floresacton/kicad-lib/3dmodels/XT30PW-M.STEP

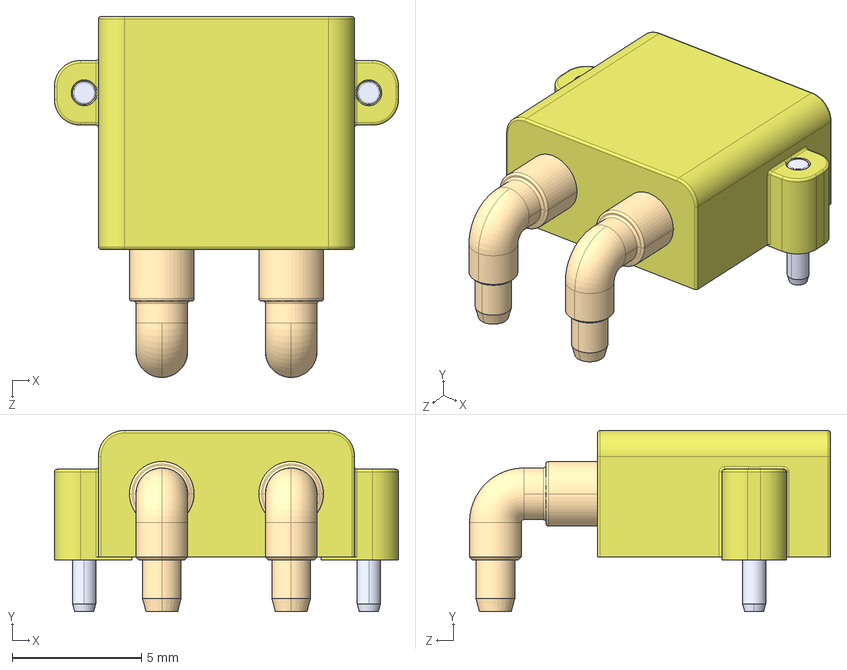
[picture p1: CAD file, 2024-11-22]
3dmodels/XT30PW-M.STEP
13.3 x 7.00 x 14.0 mm
