floresacton/kicad-lib/3dmodels/SM04B-SRSS-TB.STEP

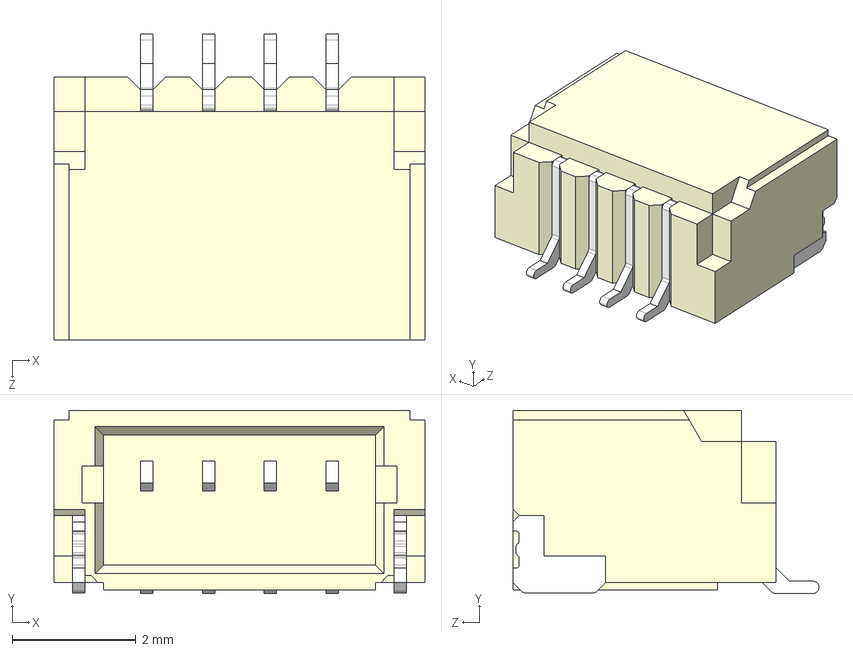
[picture p2: CAD file, 2024-10-28]
3dmodels/SM04B-SRSS-TB.STEP
6.00 x 2.96 x 4.95 mm
