floresacton/kicad-lib/3dmodels/BM04B-SRSS-TB.STEP

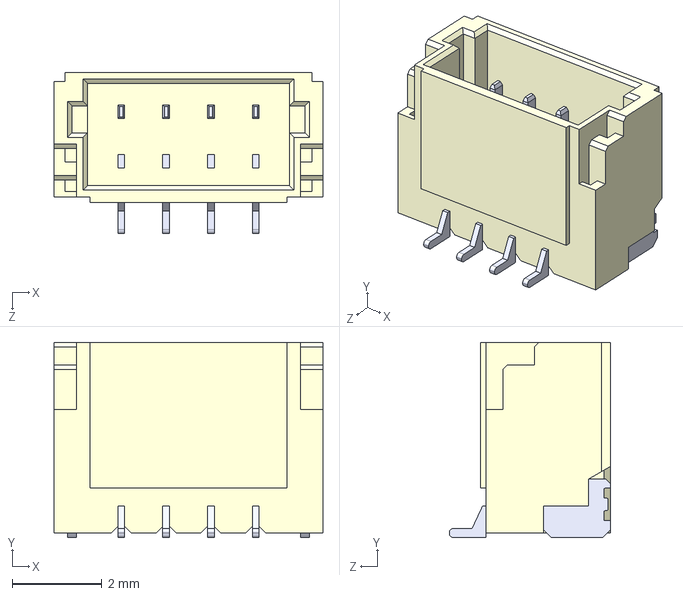
[picture p3: CAD file, 2024-08-16]
3dmodels/BM04B-SRSS-TB.STEP
6.00 x 4.35 x 3.60 mm
