floresacton/kicad-lib/3dmodels/Crystal_1612.step

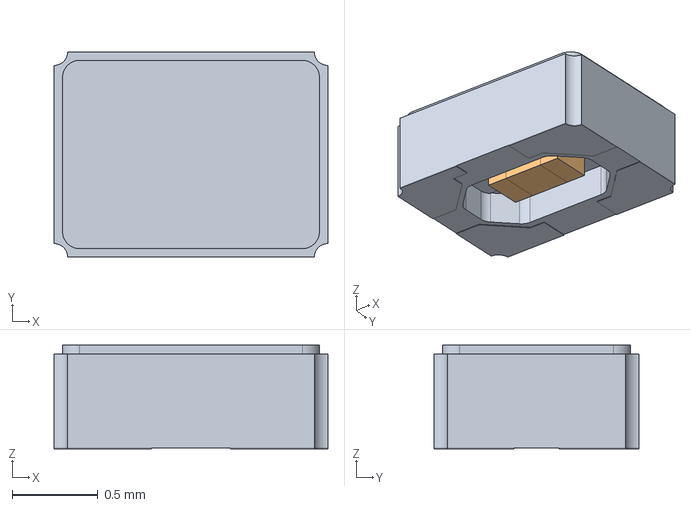
[picture p4: CAD file, 2024-08-16]
3dmodels/Crystal_1612.step
1.60 x 1.20 x 0.605 mm
PKG
Thermistor
