floresacton/kicad-lib/3dmodels/SMA_InnerBore_Angled.STEP

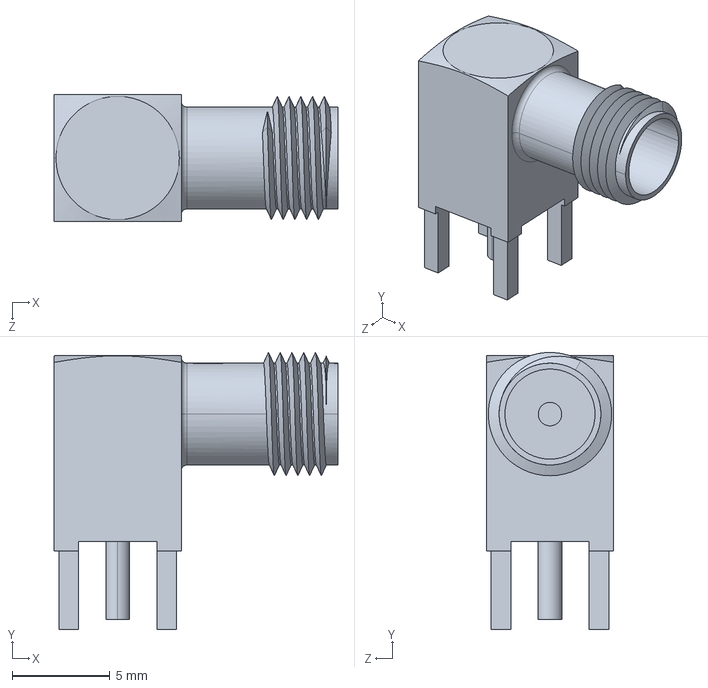
[picture p5: CAD file, 2024-07-02]
3dmodels/SMA_InnerBore_Angled.STEP
14.5 x 14.1 x 6.50 mm
