floresacton/kicad-lib/3dmodels/CR1220.step

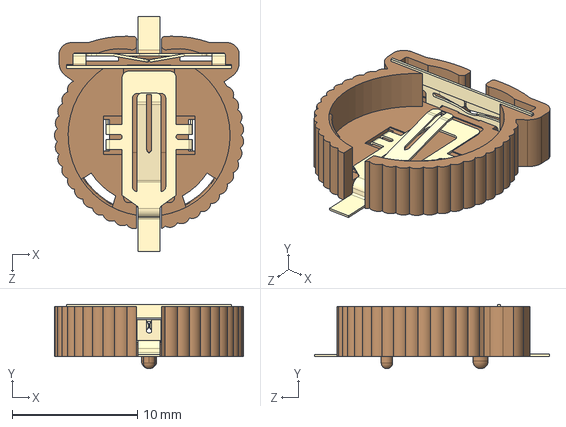
[picture p6: CAD file, 2024-07-02]
3dmodels/CR1220.step
15.1 x 5.16 x 18.8 mm
