floresacton/kicad-lib/3dmodels/GPS-02 v3.step

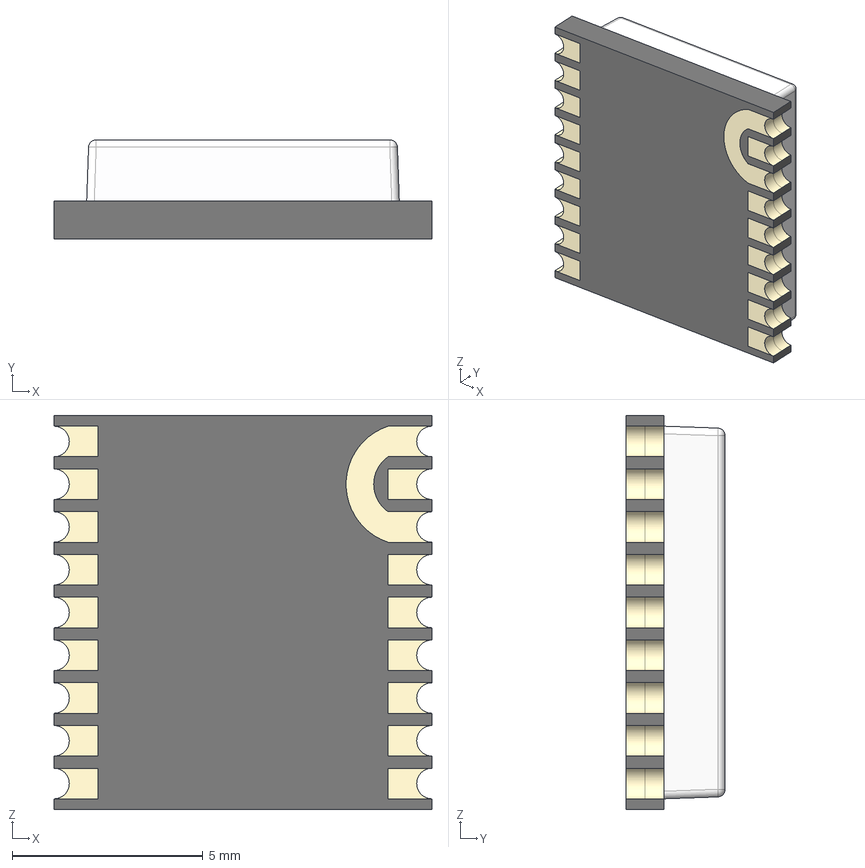
[picture p7: CAD file, 2024-07-01]
3dmodels/GPS-02 v3.step
9.90 x 2.60 x 10.3 mm
