floresacton/kicad-lib/3dmodels/OLED_SSD1312_I2C_0.96.step

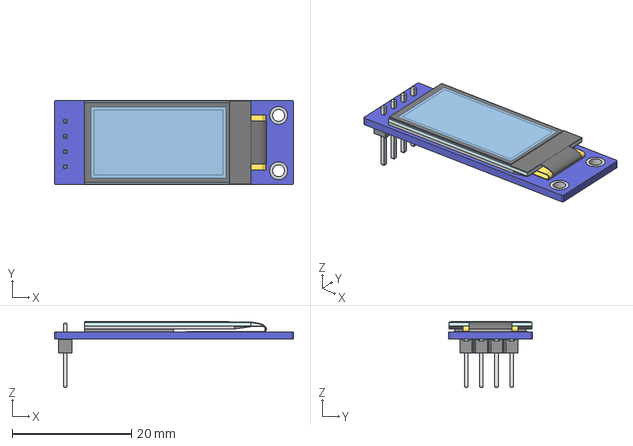
[picture p8: CAD file, 2024-07-01]
3dmodels/OLED_SSD1312_I2C_0.96.step
40.1 x 14.1 x 11.1 mm
