floresacton/kicad-lib/3dmodels/WJ127-5_0-2P.STEP

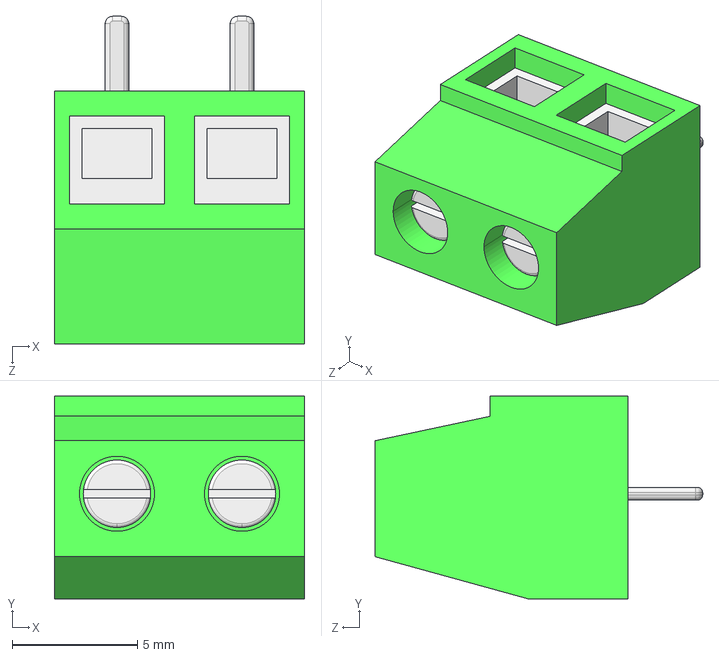
[picture p9: CAD file, 2024-07-01]
3dmodels/WJ127-5_0-2P.STEP
10.0 x 8.10 x 13.1 mm
