floresacton/kicad-lib/3dmodels/SW_PUSH_6mm_H9.5mm.STEP

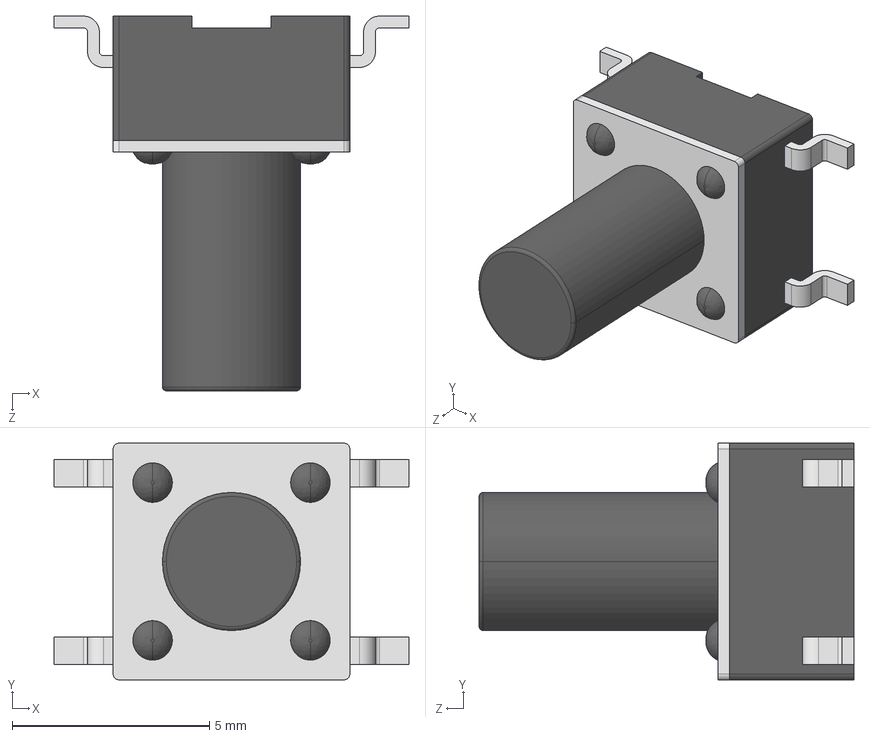
[picture p10: CAD file, 2024-07-01]
3dmodels/SW_PUSH_6mm_H9.5mm.STEP
9.00 x 6.00 x 9.50 mm
