floresacton/kicad-lib/3dmodels/SSD1309 2.42_ OLED v1.step

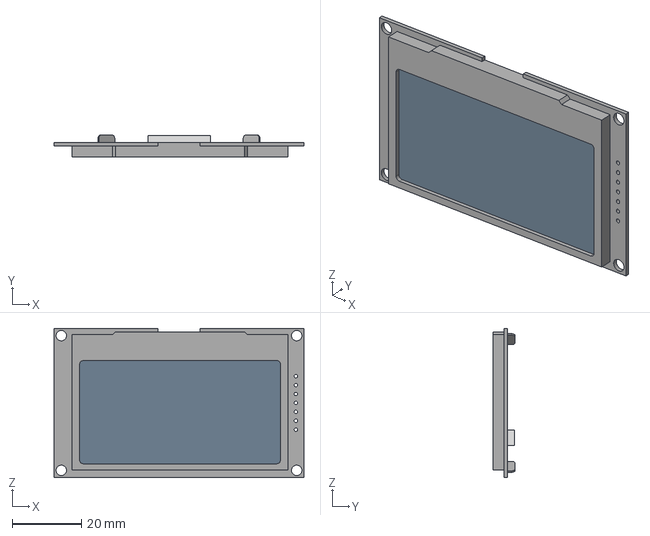
[picture p11: CAD file, 2024-07-01]
3dmodels/SSD1309 2.42_ OLED v1.step
72.0 x 6.40 x 43.0 mm
