floresacton/kicad-lib/3dmodels/Display_OLED_SSD1306_1.3inch.STEP

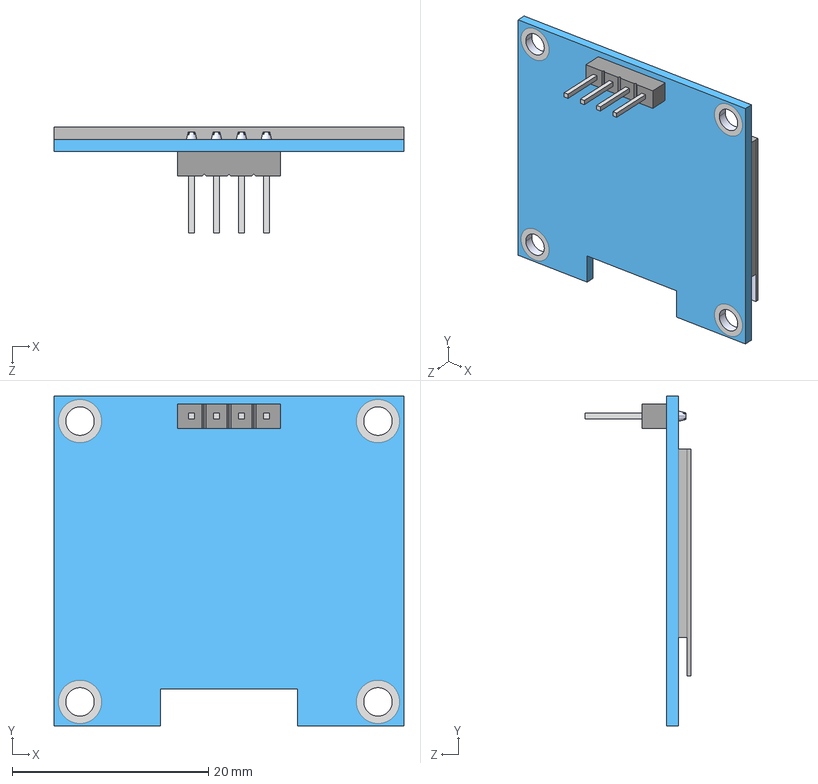
[picture p12: CAD file, 2024-07-01]
3dmodels/Display_OLED_SSD1306_1.3inch.STEP
35.7 x 33.6 x 10.8 mm
