floresacton/kicad-lib/3dmodels/SM02B-SRSS-TB-LF--SN---3DModel-STEP-56544.STEP

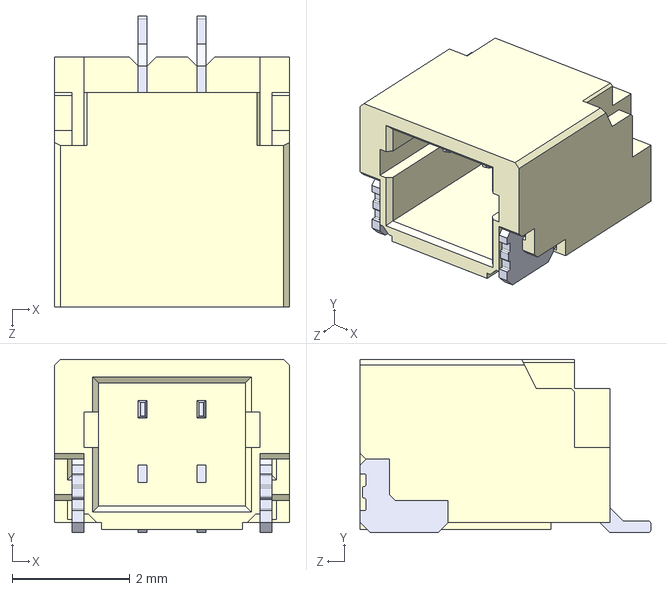
[picture p13: CAD file, 2024-06-06]
3dmodels/SM02B-SRSS-TB-LF--SN---3DModel-STEP-56544.STEP
4.00 x 2.95 x 4.95 mm
