floresacton/kicad-lib/3dmodels/SM06B-SRSS-TB(LF)(SN)--3DModel-STEP-269445.STEP

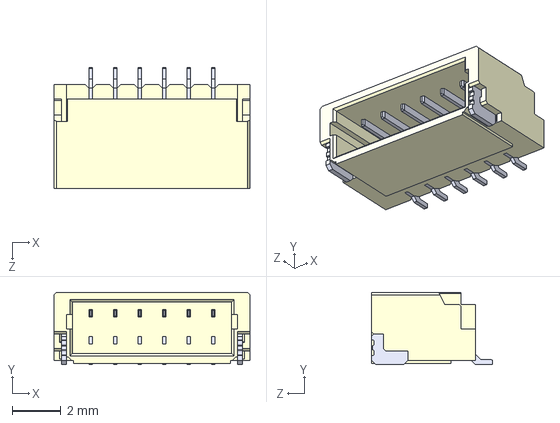
[picture p14: CAD file, 2024-06-05]
3dmodels/SM06B-SRSS-TB(LF)(SN)--3DModel-STEP-269445.STEP
8.00 x 2.95 x 4.95 mm
