floresacton/kicad-lib/3dmodels/screwterminalpug_6P_P5.08.step

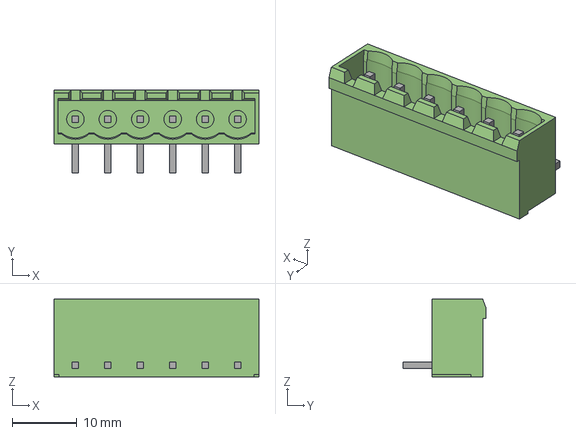
[picture p15: CAD file, 2024-07-06]
3dmodels/screwterminalpug_6P_P5.08.step
31.6 x 12.8 x 12.0 mm
