floresacton/kicad-lib/3dmodels/24939.STEP

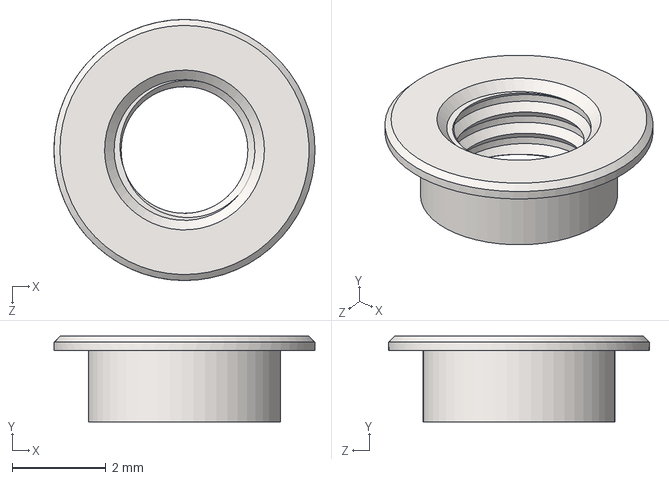
[picture p16: CAD file, 2024-06-06]
3dmodels/24939.STEP
5.56 x 1.83 x 5.56 mm
