floresacton/kicad-lib/(commit log)

2024-04-23 Add footprints for rc-remote
2024-04-25 Add ICM-42670-P footprint symbol
2024-04-26 Fix joystick footprint
2024-04-27 Change some footprints
2024-05-19 Add SS54 diode
2024-05-20 Add MDD2302 low threshold n mosfet
2024-06-05 Add JST-SH horizontal 6P
    [SM06B-SRSS-TB(LF)(SN)--3DModel-STEP-269445.STEP]
2024-06-06 Add M3 inserts and JST SH 2P
    [24939.STEP, SM02B-SRSS-TB-LF--SN---3DModel-STEP-56544.STEP]
2024-06-06 Add AA battery holder
2024-06-07 Change hole size
2024-06-07 Add power footprint
2024-06-15 Add footprint for microSD
2024-06-30 Add fpc connector footprint
2024-07-01 Add models
    [Display_OLED_SSD1306_1.3inch.STEP, OLED_SSD1312_I2C_0.96.step, SSD1309 2.42_ OLED v1.step, SW_PUSH_6mm_H9.5mm.STEP, WJ127-5_0-2P.STEP]
2024-07-01 Make footprints
2024-07-01 Import 3d model
    [GPS-02 v3.step]
2024-07-02 Add 3d models
    [CR1220.step, SMA_InnerBore_Angled.STEP]
2024-07-02 Add SMA connector
2024-07-02 Copied in footprint
2024-07-06 Add terminal plug 6P
    [screwterminalpug_6P_P5.08.step]
2024-07-06 Add display footprint
2024-07-06 Rename screw terminal plug
2024-07-07 Add pin 1 indicator
2024-07-15 Add rgbw led driver
2024-07-15 Create rgbw led
2024-07-15 Change rgbw led designator
2024-08-15 Make FPC 8P bottom side contactor footprint
2024-08-15 Create jlc 4 layer template
    [jlc4.kicad_pcb, jlc4.kicad_sch]
2024-08-15 Add kicad path info to readme
2024-08-15 Add linked footprint and symmbol libraries to template
2024-08-16 Make insert hole slightly smaller
2024-08-16 Add 1612 crystal footprint and 3d model
    [Crystal_1612.step]
2024-08-16 Save 1612 footprint
2024-08-16 Add vertical 4 pin jst sh
    [BM04B-SRSS-TB.STEP]
2024-08-27 Create adc footprint
2024-08-28 Change minimum silkscreen thickness
2024-09-02 Create fpc 12 pin footprint
2024-09-04 Create 10 pin fpc
2024-09-04 Remove fpc footprint from BOM
2024-09-04 Move base template into seperate folder
    [base.kicad_sch]
2024-09-04 Implement linked files
    [rigid4.kicad_sch]
2024-09-04 Create symbolic links and linker script
    [flex2.kicad_pcb, flex2.kicad_sch]
2024-09-04 Change base folder to hidden and update links
    [base.kicad_sch, flex2.kicad_sch, rigid4.kicad_sch]
2024-09-04 Ignore kicad backups
2024-09-04 Remove kicad file links
    [base.kicad_sch, flex2.kicad_sch, rigid4.kicad_sch]
2024-09-08 Add AAA battery holder footprint
2024-09-08 Remove AA battery holder
2024-09-08 Add AAA battery holder 3d model
2024-10-28 Add jst sh 4P
    [SM04B-SRSS-TB.STEP]
2024-11-22 Add xt30 connector
    [XT30PW-M.STEP]
2024-11-27 Add capacitor
2024-11-30 Add footprints and symbols
2025-08-25 Update to kicad 9
    [flex2.kicad_pcb, flex2.kicad_sch, rigid4.kicad_pcb, rigid4.kicad_sch]
2025-08-31 Add sim schematic only template
    [sim.kicad_pcb, sim.kicad_sch]
2025-10-31 Add aluminum template
    [alu1.kicad_pcb, alu1.kicad_sch]
2025-11-09 Update template format and add rigid2
    [template.kicad_pcb, template.kicad_sch]
